chrisdefrancisci/VCF-MS20/VCF.kicad_pcb

## KiCad design VCF.kicad_pcb (2021-06-01)

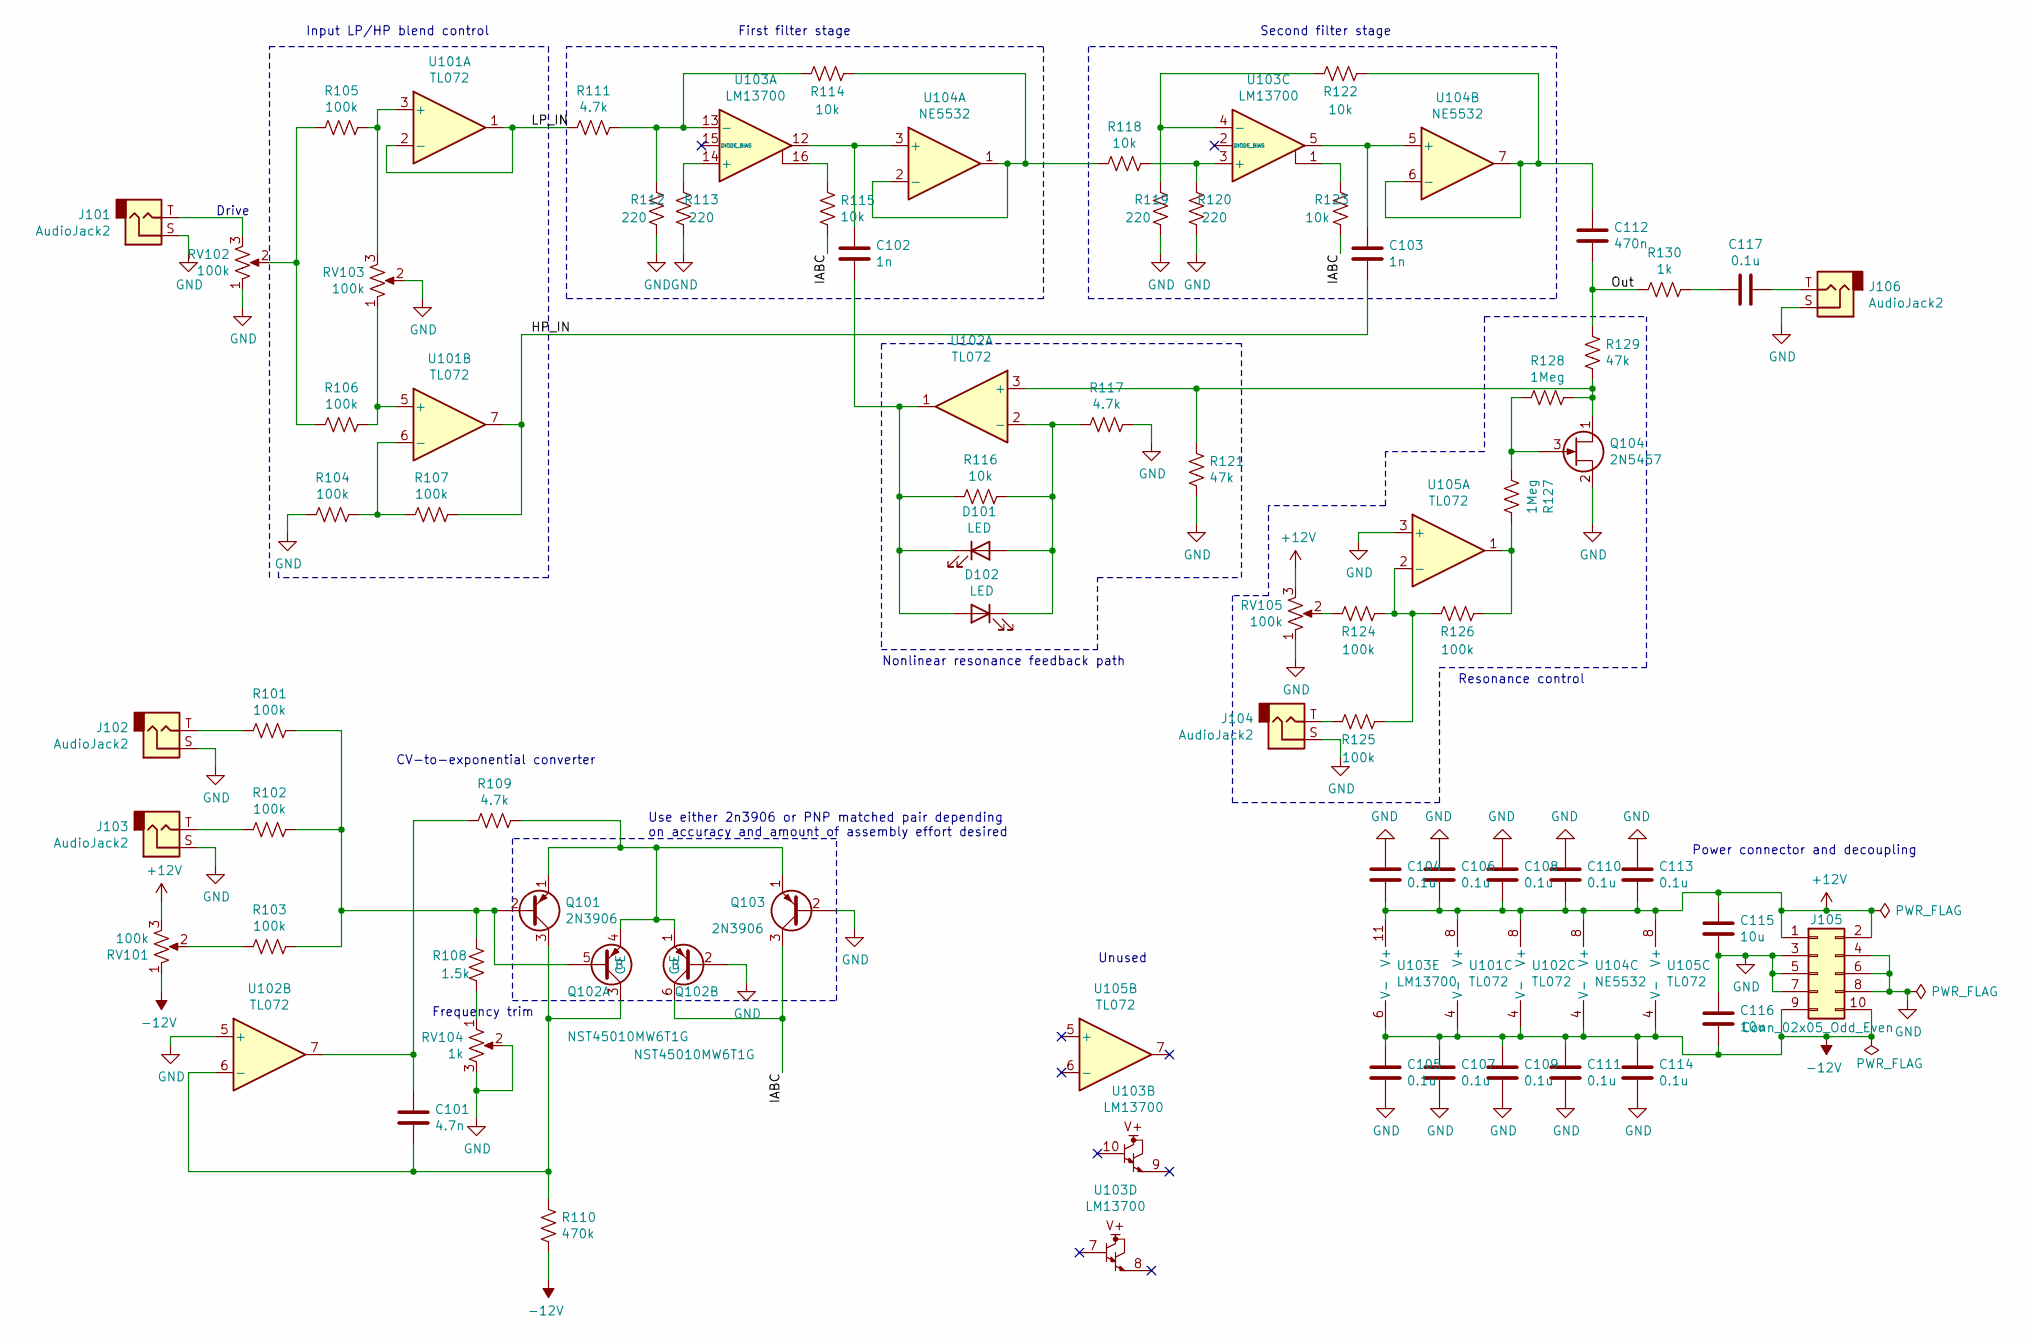
[picture p1: schematic VCF.sch]

Parts:
C101: 4.7n; C_0402_1005Metric; LCSC C1538
C102, C103: 1n; C_0402_1005Metric; LCSC C1523
C104, C105, C106, C107, C108, C109, C110, C111, C113, C114, C117: 0.1u; C_0402_1005Metric; LCSC C1525
C112: 470n; C_0402_1005Metric; LCSC C47339
C115, C116: 10u; C_0402_1005Metric; LCSC C15525
D101, D102: LED; LED_D5.0mm
J101, J102, J103, J104, J106: AudioJack2; A-2563
J105: Conn_02x05_Odd_Even; PinHeader_2x05_P2.54mm_Vertical
Q101, Q103: 2N3906; TO-92_Inline
Q102: NST45010MW6T1G; SOT-363_SC-70-6_Handsoldering
Q104: 2N5457; TO-92_Inline
R101, R102, R103, R104, R105, R106, R107, R124, R125, R126: 100k; R_0402_1005Metric; LCSC C25741
R108: 1.5k; R_0402_1005Metric; LCSC C25867
R109, R111, R117: 4.7k; R_0402_1005Metric; LCSC C25900
R110: 470k; R_0402_1005Metric; LCSC C25792
R112, R113, R119, R120: 220; R_0402_1005Metric; LCSC C25091
R114, R115, R116, R118, R122, R123: 10k; R_0402_1005Metric; LCSC C25744
R121, R129: 47k; R_0402_1005Metric; LCSC C25792
R127, R128: 1Meg; R_0402_1005Metric; LCSC C26083
R130: 1k; R_0402_1005Metric; LCSC C11702
RV101, RV102, RV103, RV105: 100k; A-5513
RV104: 1k; Potentiometer_Bourns_3296X_Horizontal
U101, U102, U105: TL072; SOIC-8_3.9x4.9mm_P1.27mm; LCSC C6961
U103: LM13700; DIP-16_W7.62mm
U104: NE5532; SOIC-8_3.9x4.9mm_P1.27mm; LCSC C7426

Connections:
+12V: C104.2, C106.2, C108.2, C110.2, C113.2, C115.1, J105.1, J105.2, RV101.3, RV105.3, U101.8 (V+), U102.8 (V+), U103.11 (V+), U104.8 (V+), U105.8 (V+)
-12V: C105.1, C107.1, C109.1, C111.1, C114.1, C116.2, J105.9, J105.10, R110.2, RV101.1, U101.4 (V-), U102.4 (V-), U103.6 (V-), U104.4 (V-), U105.4 (V-)
/HP_IN: C103.2, R107.1, U101.7
/IABC: Q102.6 (C), Q103.3 (C), R115.2, R123.2
/LP_IN: R111.2, U101.1, U101.2 (-)
/Out: C112.1, R129.2, R130.2
GND: C104.1, C105.2, C106.1, C107.2, C108.1, C109.2, C110.1, C111.2, C113.1, C114.2, C115.2, C116.1, J101.S, J102.S, J103.S, J104.S, J105.3, J105.4, J105.5, J105.6, J105.7, J105.8, J106.S, Q102.2 (B), Q103.2 (B), Q104.2 (S), R104.2, R112.2, R113.2, R117.2, R119.2, R120.2, R121.1, RV102.1, RV103.2, RV104.2, RV104.3, RV105.1, U102.5 (+), U105.3 (+)
unnamed: C101.1, R109.2, U102.7
unnamed: C101.2, Q101.3 (C), Q102.3 (C), R110.1, U102.6 (-)
unnamed: C102.1, U103.12, U104.3 (+)
unnamed: C102.2, D101.1 (K), D102.2 (A), R116.2, U102.1
unnamed: C103.1, U103.5, U104.5 (+)
unnamed: C112.2, R122.1, U104.6 (-), U104.7
unnamed: C117.1, J106.T
unnamed: C117.2, R130.1
unnamed: D101.2 (A), D102.1 (K), R116.1, R117.1, U102.2 (-)
unnamed: J101.T, RV102.3
unnamed: J102.T, R101.2
unnamed: J103.T, R102.2
unnamed: J104.T, R125.1
unnamed: Q101.1 (E), Q102.1 (E), Q102.4 (E), Q103.1 (E), R109.1
unnamed: Q101.2 (B), Q102.5 (B), R101.1, R102.1, R103.1, R108.1
unnamed: Q104.1 (D), R121.2, R128.1, R129.1, U102.3 (+)
unnamed: Q104.3 (G), R127.2, R128.2
unnamed: R103.2, RV101.2
unnamed: R104.1, R107.2, U101.6 (-)
unnamed: R105.1, RV103.3, U101.3 (+)
unnamed: R105.2, R106.2, RV102.2
unnamed: R106.1, RV103.1, U101.5 (+)
unnamed: R108.2, RV104.1
unnamed: R111.1, R112.1, R114.2, U103.13 (-)
unnamed: R113.1, U103.14 (+)
unnamed: R114.1, R118.2, U104.1, U104.2 (-)
unnamed: R115.1, U103.16
unnamed: R118.1, R120.1, U103.3 (+)
unnamed: R119.1, R122.2, U103.4 (-)
unnamed: R123.1, U103.1
unnamed: R124.1, RV105.2
unnamed: R124.2, R125.2, R126.1, U105.2 (-)
unnamed: R126.2, R127.1, U105.1

Notes on the sheet:
Input LP/HP blend control
Drive
First filter stage
Second filter stage
Resonance control
Nonlinear resonance feedback path
CV-to-exponential converter
Unused
Power connector and decoupling
Frequency trim
Use either 2n3906 or PNP matched pair depending on accuracy and amount of assembly effort desired

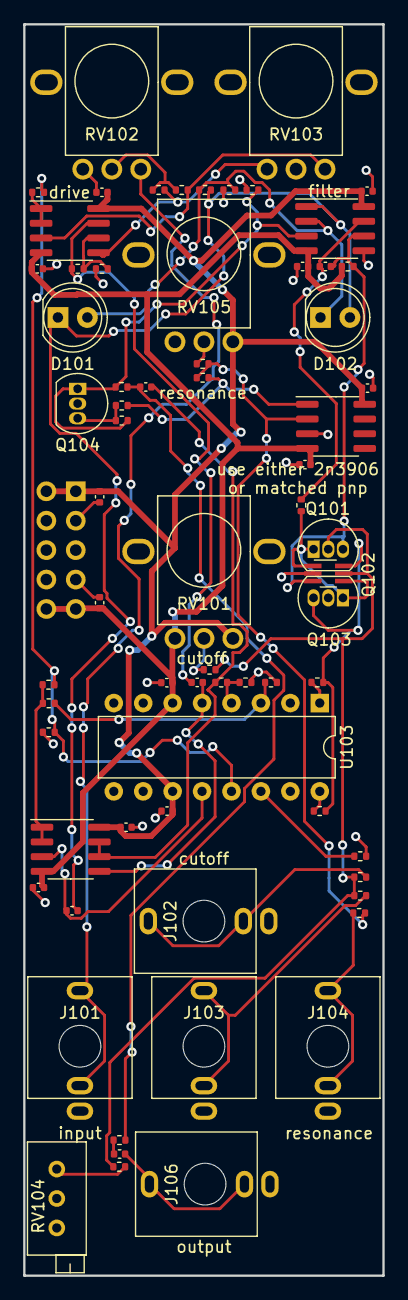
[picture p2: board VCF.kicad_pcb from above]

Board: 2 copper layers, 31.0 x 108.0 mm, 69 parts (1 on the bottom side), 40 nets.
