chrisdefrancisci/VCF-MS20/(commit log)

2021-05-18 Finished schematic including CV resonance
    [VCF.sch]
2021-05-18 Added SMT option for PNP current mirror
    [VCF.sch]
2021-05-18 Assigned footprints to all components
    [VCF.sch]
2021-05-19 Finished pcb design
    [VCF.kicad_pcb]
2021-05-19 Generated gerbers and manufacturing files
    [VCF-BOM.csv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]
2021-06-01 fixed backwards cutoff frequency potentiometer
    [VCF-B_Cu.gbr, VCF-B_Mask.gbr, VCF-B_Paste.gbr, VCF-B_SilkS.gbr, VCF-Edge_Cuts.gbr, VCF-F_Cu.gbr, VCF-F_Mask.gbr, VCF-F_Paste.gbr]
